miyagoshigotono-lgtm/neko-weight/gohan-age-age/README.md

# ご飯アゲアゲ君

猫用自動給餌器。**弾倉式スクリューコンベア**方式。

太った猫（8kg台）の減量が目的。床置きの餌を食べ放題にさせないため、猫を識別する代わりに「1日分をあらかじめ小分けし、機械が時間差で出す」方式を採る。

- 水平パイプ内の一条スクリューの**各ピッチを1回分の小部屋（弾倉）**として使う
- 1回の給餌＝**スクリュー1回転**＝全部屋が1ピッチ前進＝末尾の部屋の中身が餌皿へ落下
- ホッパーを持たず、毎朝の手作業で各部屋に小分けするため**吐出量の校正が不要**
- 1日9回。制御は Digispark（ATtiny85）、装填完了ボタンの押下時刻を起点とした相対計時

詳細は **[SPEC.md](SPEC.md)** を参照。

## 現在の状態

**設計段階。実装は未着手。**

寸法を確定するには実測値が必要です（SPEC.md §7）。特に次の一点が本方式の生命線で、ここが崩れると方式ごと見直しになります。

> **1回転で本当に1ピッチ進むか** — 色違いの1粒を目印に10回転させて確認する

## 次にやること

1. SPEC.md §7 の実測項目を埋める（フードの粒径、1ピッチあたりのグラム数、手持ち歯車の歯数、モーターの電流）
2. 獣医に適正カロリーと減量ペースを確認する（急激な減量は肝リピドーシスのリスクがある）
3. 上記が埋まってからパイプ・スクリューの寸法を決め、造形と検証に入る

並行して、体重記録アプリ（`neko-weight`）に1日の給与グラム数を割り出させる構想があります（SPEC.md §9）。ここで出る「1部屋あたりのグラム数」がパイプ内径とピッチを決めるため、**アプリを先に作る順序もあり得ます。**

## 関連

- 手持ち部品（2SK4017、1N4007、0.1µF、ユニバーサル基板）は畑の自動水やりプロジェクトと共通。取り合いに注意

## このディレクトリの位置づけ

本来は独立したリポジトリ `gohan-age-age` として管理する予定のプロジェクトですが、現在は `neko-weight` リポジトリ内に間借りしています。リポジトリを用意でき次第、このディレクトリごと移設します。それまでの間、猫の体重記録アプリ本体（リポジトリ直下の `index.html` / `app.js` など）とは無関係な独立したプロジェクトとして扱ってください。
