miyagoshigotono-lgtm/neko-weight/(commit log)

2026-08-11 Add ご飯アゲアゲ君 (automatic cat feeder) specification
    弾倉式スクリューコンベア方式の自動給餌器の仕様書を gohan-age-age/SPEC.md
    として追加。機構・駆動系・1回転割り出し・ATtiny85 制御・回路・実測待ち項目
    までの 2026-08 時点の確定／未確定事項をまとめたもの。
    Claude-Session: https://claude.ai/code/session_01TnUqB5Uz8oBiUBvRZCz5jU
2026-08-11 Add README for ご飯アゲアゲ君
    方式の要約、現在の状態（設計段階・実装未着手）、次にやること、および
    neko-weight リポジトリ内に間借りしている位置づけを記載。
    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
2026-08-11 Add §9: 体重記録アプリとの連携構想
    neko-weight の体重時系列から1日の給与グラム数を割り出し、9で割って
    1部屋あたりのグラム数を出す構想を追記。RER ベースの計算式、試算、
    週次減量率による補正ループ、および横取りによる摂取量のズレを記載。
    この「1部屋あたりのグラム数」は §7 の未実測項目に直結するため、
    アプリを先に作る順序もあり得ることを README にも併記。
    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
2026-08-23 Add CLAUDE.md with response guidelines (#2)
    回答を短くすること、手仕事・工作の手順やコツは書かないこと、
    計算・寸法の根拠・仕様整合・ファームウェアに絞ることを明文化。
    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
2026-10-03 ATtiny85 ファームウェアを追加 (#3)
    * Add ATtiny85 firmware for ご飯アゲアゲ君
    SPEC §5 の給餌シーケンスを実装。装填ボタンの押下を起点に millis() で
    計時し、9回の給餌を行う。1回の給餌は不感帯・磁石検出・タイムアウトの
    3段構成。停電後は待機状態とし、ボタン押下まで動かない。
    SPEC §5 のピン割り当てから P0 と P1 を入れ替えている。オンボードLEDが
    P1 に載る基板では、LEDの順方向電圧が内蔵プルアップに勝ってボタンが
    常時LOWと読まれるため。理由はソース冒頭に記載。
    Claud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
